LieBtrau/pulse-dtmf-converter/README.md

# pulse-dtmf-converter
Converter from pulse dialing to tone dialing

More info about this project can be found on [Hackaday.io](https://hackaday.io/project/28557-pulse-to-tone-converter).

This is the link to the [original github repository](https://github.com/LieBtrau/pulse-dtmf-converter/).
