LieBtrau/pulse-dtmf-converter/Hardware/Schematic_BRD170127R1.pdf

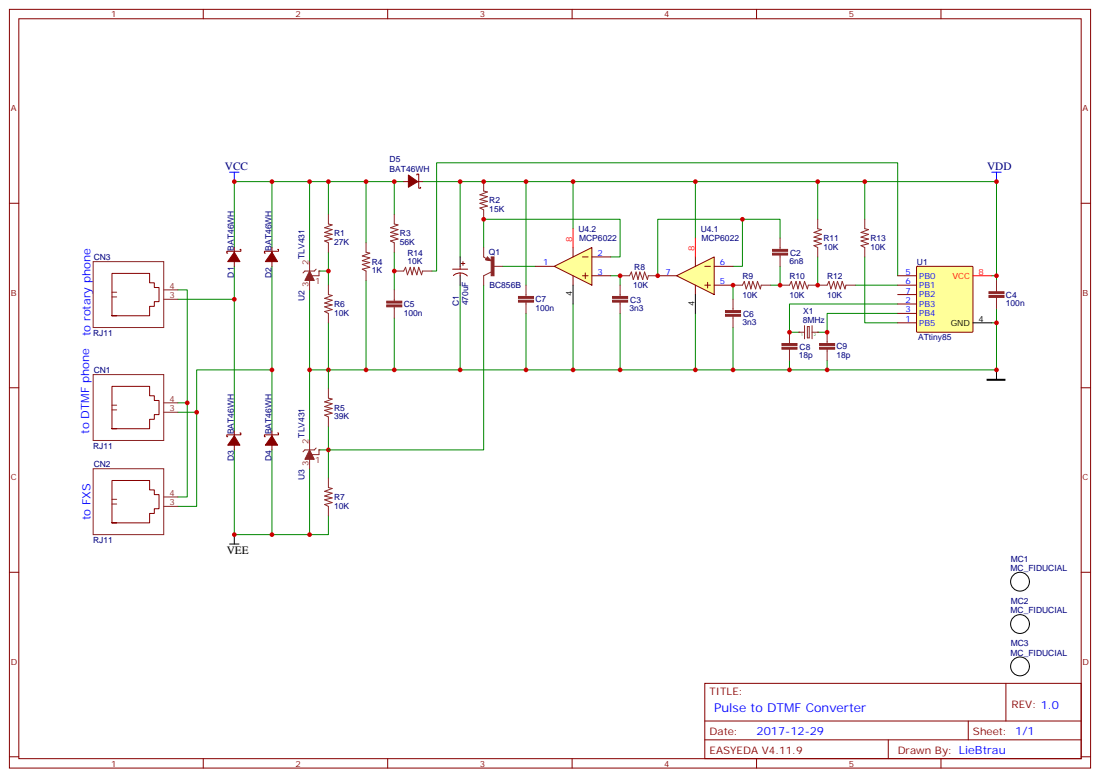
[picture p1: page 1]

to FXS to DTMF phone to rotary phone

TITLE:
Pulse to DTMF Converter
