LieBtrau/pulse-dtmf-converter/(list of files, drawings)

Other design files:
Hardware/BRD170127.pcbdoc
Hardware/Pulse_to_DTMF_Converter.schdoc
