LieBtrau/pulse-dtmf-converter/(threads)

Thread 2 (2022-03-15):

Schematic

danielkucera, 2022-03-15:
Hello,
can you please provide pdf schematic, ideally into releases?
I don't have altium and the web viewer refuses to show it (https://www.altium.com/viewer/)

Thank you.

LieBtrau, 2022-03-15:
Hi Daniel,
The pcb-design is on [EasyEDA](https://easyeda.com/LieBtrau/New_Project-06f8d9abfb004e898edb54cca7790566).  You can immediately find the schematic and pcb-design there.  You could even start to change it if you want, no need to download any software.
The schematic on EasyEDA is R2, while the release on github is still R1.  I don't feel much for making a new github release, as there's no change in code on github and it has been some years now that I had a look at this project.
If you had clicked on the link in the readme of this github, you would also have found this (just like >3.5K people before you ;-) ).

LieBtrau, 2022-03-15:
Well Daniel, you were right.  There were no schematics in there.
So, for your and everyone else's convenience, I've added a schematic in release R1.

Closed 2022-03-15.

Thread 3 (2023-10-27):

I'm trying to understand how everything works

TheAelig, 2023-10-27:
Hello, I would like to better understand your explanation and how it works, if I buy a pcb with the files provided on your github:

1 - will there already be ports to connect cables on the motherboard or is it something to add in addition (by buying it somewhere or I'm not sure)
2 - is it plug and play, or is there a firmware to be added?
Thanks in advance
PS: if there are any mistakes in the message, it's because I'm French and I do my best with English.

LieBtrau, 2023-10-27:
Hi,
As shown in the [readme](https://github.com/LieBtrau/pulse-dtmf-converter#readme), you can find more information on the [Hackaday.io page](https://hackaday.io/project/28557-pulse-to-tone-converter).
1.  see the pictures on the hackaday.io page
2. This project contains a [Firmware folder](https://github.com/LieBtrau/pulse-dtmf-converter/tree/master/Firmware).  That's the firmware for the microcontroller on the board.  If you take a look in the [Hardware folder](https://github.com/LieBtrau/pulse-dtmf-converter/tree/master/Hardware), you'll find a PDF of the schematic.  It contains the microcontroller.

Your english is ok.

Please take some effort to go through the information that has been made publicly available to you (for free).
I have no clue what your skill level in electronics is or what is your motivation to make this project. This project might look easy, but it's not for beginners.
1. Soldering is not too difficult.  Everyone who has ever soldered SMD should be able to do it with the proper tools.
3. You'll need to install VSCode, PlatformIO and build the firmware on your computer.
4. You'll need a programmer to upload the firmware from your computer to the microcontroller.  I'm using the AVRISP MkII,  but you can use something else.
5. You'll need an oscilloscope to debug when it doesn't work.  Debugging can be very frustrating when you're not fully understanding what is going on in the circuit.  This project is even harder, because the VOIP-box that tries to decode the DTMF-pulses will not tell you what's wrong.  Either it works or it doesn't.  The circuit might take a bit of tuning.  It depends on your own installation.
