LieBtrau/pulse-dtmf-converter/Firmware/platformio/src/dtmfgenerator.cpp

/*
DtmfGenerator: library for generating DTMF-signals
Copyright (C) 2018  Christoph Tack

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
Based on :
    http://interface.khm.de/index.php/lab/interfaces-advanced/arduino-dds-sinewave-generator
    https://github.com/antonmeyer/ArduinoDTMF
*/

#include "dtmfgenerator.h"

//Sine samples LUT : one period sampled on 128 samples and quantized on 7 bit
static const byte sine128[] PROGMEM =
{
    64,67,70,73,76,79,82,85,88,91,94,96,99,102,104,106,109,111,113,115,117,118,120,
    121,123,124,125,126,126,127,127,127,127,127,127,127,126,126,125,124,123,121,120,
    118,117,115,113,111,109,106,104,102,99,96,94,91,88,85,82,79,76,73,70,67,64,60,57,
    54,51,48,45,42,39,36,33,31,28,25,23,21,18,16,14,12,10,9,7,6,4,3,2,1,1,0,0,0,0,0,
    0,0,1,1,2,3,4,6,7,9,10,12,14,16,18,21,23,25,28,31,33,36,39,42,45,48,51,54,57,60
};
//Precalculating DDS tuning words:
//  tword_m = pow(2,bitwidth) * dfreq / refclk;
//      where refclk = F_CPU / 256 for fast PWM, in [Hz]
//      where dfreq = desired frequency, in [Hz]
//      where bitwidth = number of bits in tuning word, here 15bit
//
//https://en.wikipedia.org/wiki/Dual-tone_multi-frequency_signaling
//      dtmf frequencies in Hz = {697,770,852,941,1209,1336,1477,1633};
#if F_CPU==8000000
static const word tWord[8] = {731,807,893,987,1268,1401,1549,1712};
#elif F_CPU==12000000
static const word tWord[8] = {487,538,596,658,845,934,1032,1142};
#elif F_CPU==16000000
static const word tWord[8] = {365,404,447,493,634,700,774,856};
#else
#error Your MCU frequency is not supported.
#endif
static volatile word twordLf;       //DDS tuning word for LF (<1KHz)
static volatile word twordHf;       //DDS tuning word for HF (>1KHz)
static volatile word phaccuLf;      //DDS phase accumulator for LF
static volatile word phaccuHf;      //DDS phase accumulator for HF
#ifdef ARDUINO_AVR_PROTRINKET3FTDI
const byte dtmfpin=3;
#elif ARDUINO_AVR_ATTINYX5
const byte dtmfpin=1;                   //OC1A (pin 6)
#endif
static void setDuty();

void DtmfGenerator::init (void)
{
    timer.initialize();
    timer.setPrescaler(Timer::CK1);
}

bool DtmfGenerator::generateTone(char key)
{
    key = (isLowerCase(key) ? 'A' + key - 'a' : key);   // convert to upper case
    char* pch= strchr(keypad, key);
    if(!pch)
    {
        return false;
    }
    byte digitpos=pch-keypad;
    twordHf = tWord[(digitpos & 0x03) + 4];
    twordLf = tWord[(digitpos >> 2)];

    timer.pwm();
    timer.attachInterrupt(setDuty);
    pinMode(dtmfpin, OUTPUT);
    return true;
}

void DtmfGenerator::stopTone()
{
    timer.disablePwm();
    timer.detachInterrupt();
    digitalWrite(dtmfpin,0);            // OCR2B remains low after last generated pulse
}

void setDuty()
{
    //increase phase accu
    phaccuHf+=twordHf;
    phaccuLf+=twordLf;
    // use upper 8 bits of phase accu as frequency information
    byte pwmIndexHf=phaccuHf >> 8;
    byte pwmIndexLf=phaccuLf >> 8;
    // calculate PWM value for DTMF = HF value + 3/4 LF value
    byte pwmLow = pgm_read_byte_near(sine128 + (pwmIndexLf & 0x7F));
    byte pwmHigh = pgm_read_byte_near(sine128 + (pwmIndexHf & 0x7F));
    byte ocr = pwmHigh + pwmLow - (pwmLow>>2);
    timer.setPwmDuty(ocr);
}
