LieBtrau/pulse-dtmf-converter/(commit log)

2018-01-05 DDS generating on 46KHz with fast PWM
2018-02-07 Moving hardware timer stuff to separate class, slower but cleaner implementation
2019-06-30 Added reverse dialing option
    [pulse-dtmf-converter.ino]
2019-07-05 Bug fix in rotary dialer. It should return the number of pulses, not the read digit. Converting to digits or characters is not a functionality of that function.
    [pulse-dtmf-converter.ino, rotarydialer.cpp, rotarydialer.h]
2019-07-06 Bug fix : dtmf tones were stringed together
    [pulse-dtmf-converter.ino]
2023-02-20 bug fix + platformio migration
    [pulse-dtmf-converter.ino]
